jonathan-c-lee/elevate/README.md

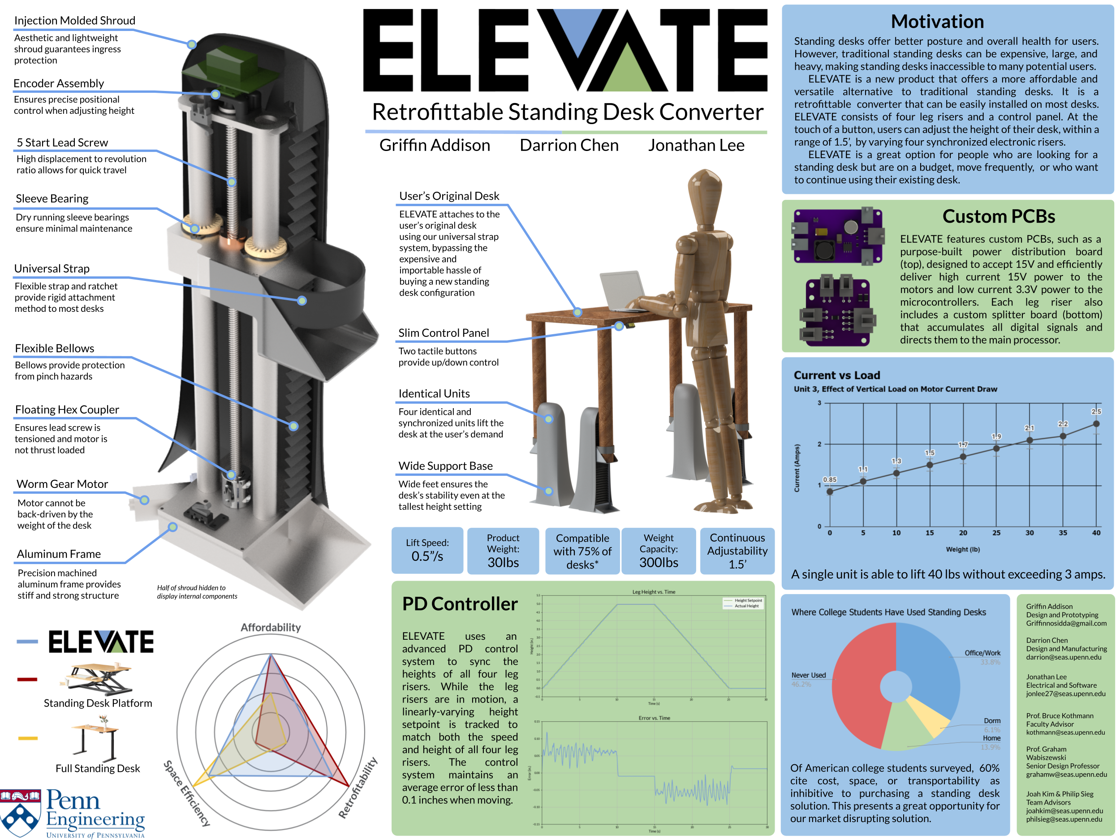
[picture p1: media/poster/ELEVATE Design Poster.png]
ELEVATE


[TESTING VIDEO](https://youtu.be/RrBmovzpD_M)
