jonathan-c-lee/elevate/media/presentations/09_ELEVATE_prototypePresentation.pdf

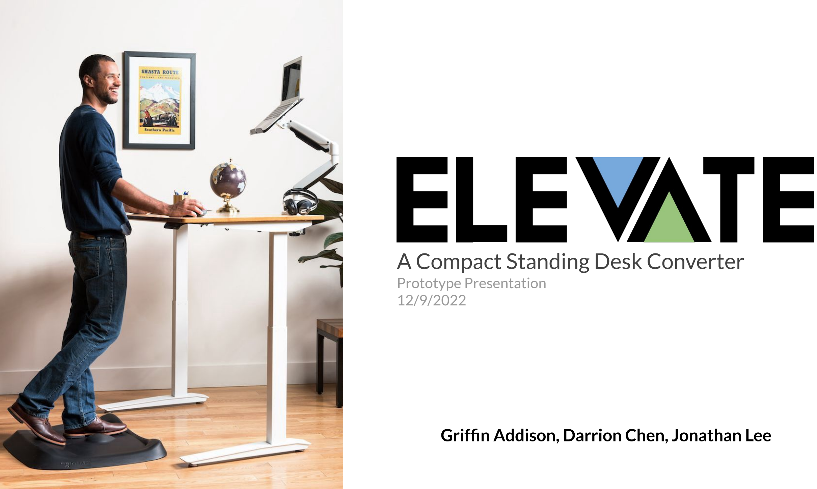
[picture p2: page 1]

A Compact Standing Desk Converter
Prototype Presentation
12/9/2022

Griffin Addison, Darrion Chen, Jonathan Lee

# The Problem

Adjustable standing desks have several physical and mental health benefits. However, there currently exists a barrier to entry for potential standing desk customers. Their only available options are to buy a new standing desk or an obtrusive standing desk converter. The former has a high cost and lacks portability while the latter lacks the full capabilities of a true adjustable standing desk.

Expensive | Lack of Portability | Obtrusive

# The Market

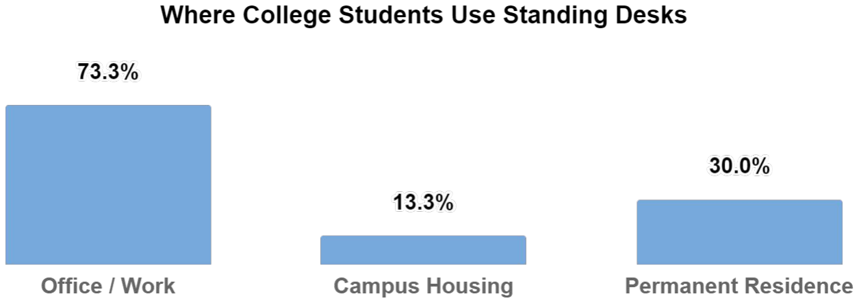
[picture p3: figure]

50%
of college students have used standing desks

86.7%
of college students who have used standing desks do not use a standing desk on campus

45%
of college students have used true standing desks

# The Competition

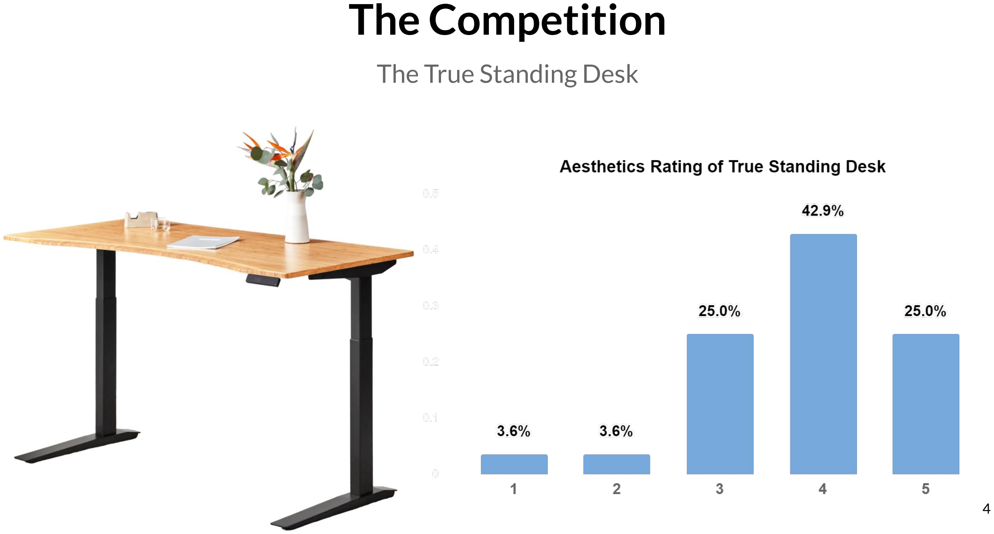
[picture p4: page 4]

The True Standing Desk

# The Competition

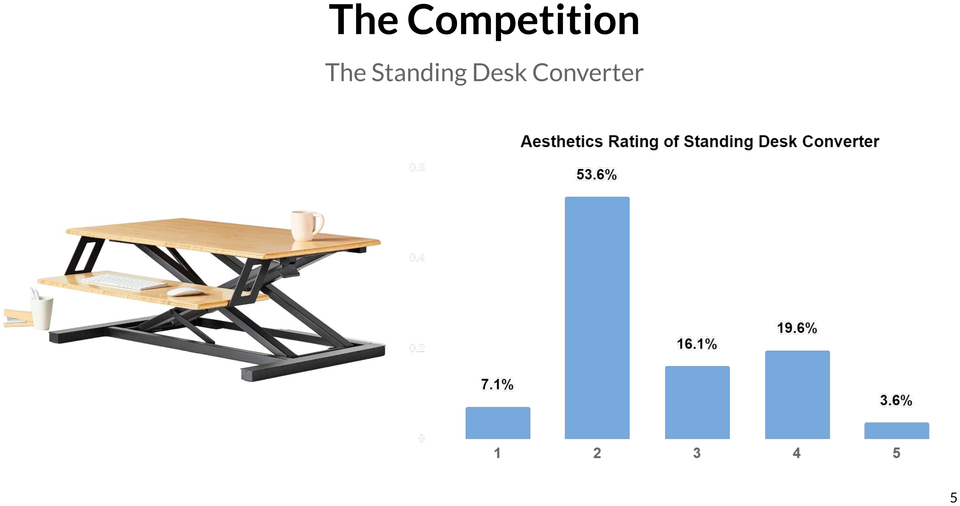
[picture p5: page 5]

The Standing Desk Converter

# The Competition

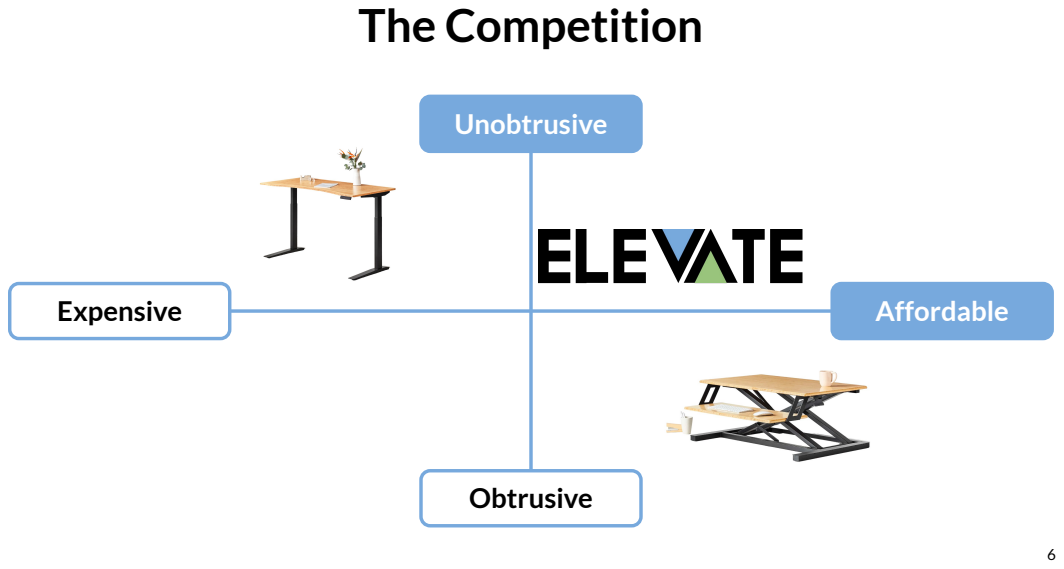
[picture p6: page 6]
Expensive; Affordable; Unobtrusive; Obtrusive

# Our Customers

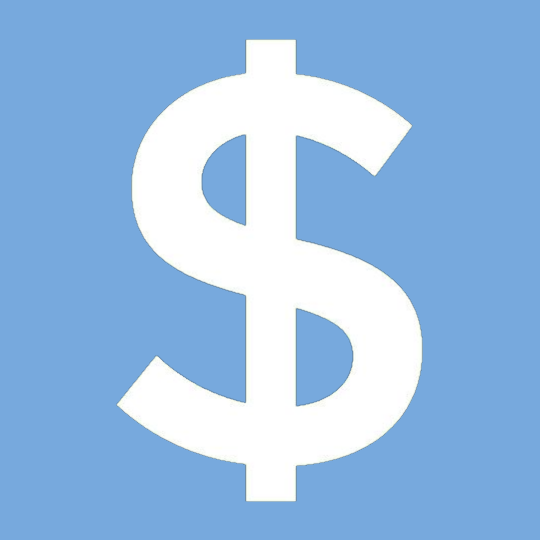
[picture p7: figure]

### Business Owners

and other employees
and employers who
have a budget and are
looking for lower cost
solutions

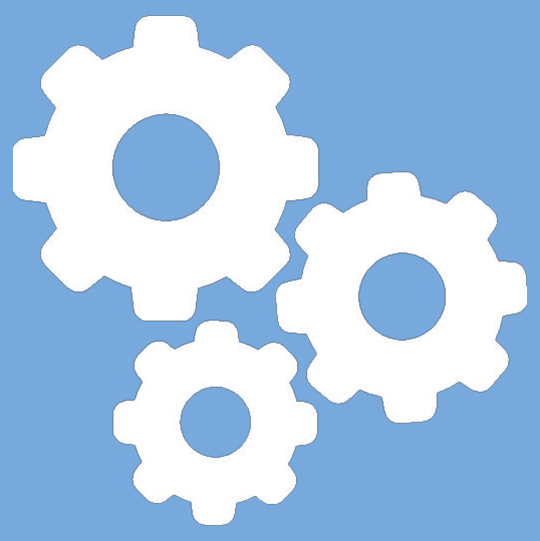
[picture p8: figure]

### Artists

And other individuals
who are looking for a
retrofittable solution
to keep their current
setup

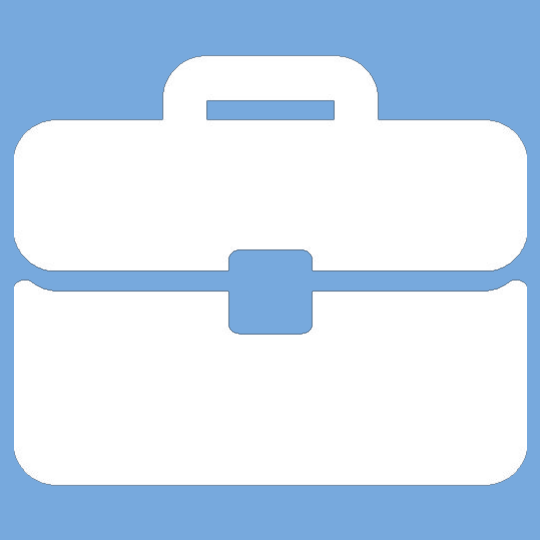
[picture p9: figure]

### College Students

and other individuals
who do not have a
permanent desk setup
and are looking for a
portable solution

# System Characteristics

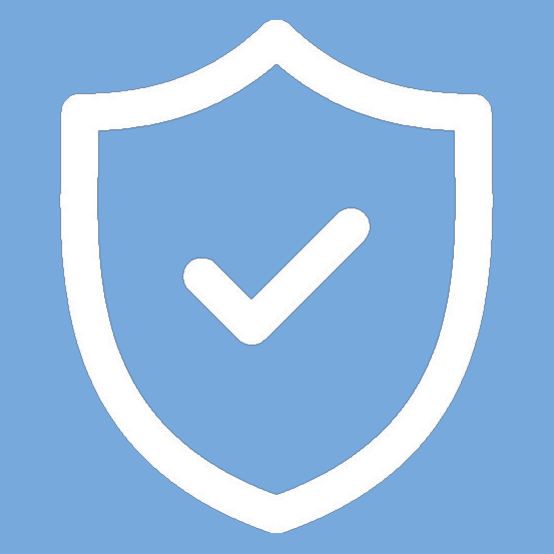
[picture p10: figure]
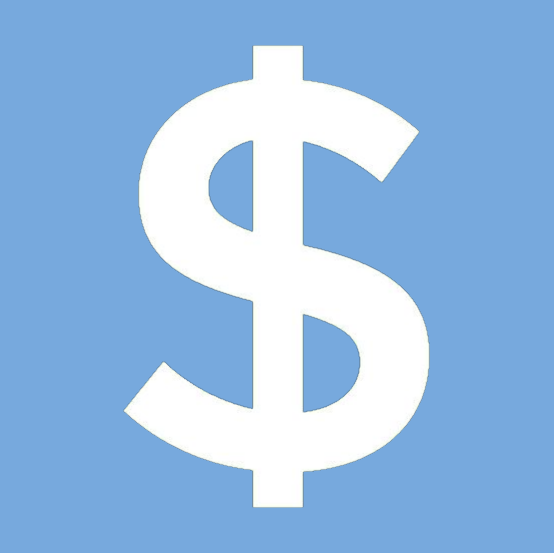
[picture p11: figure]
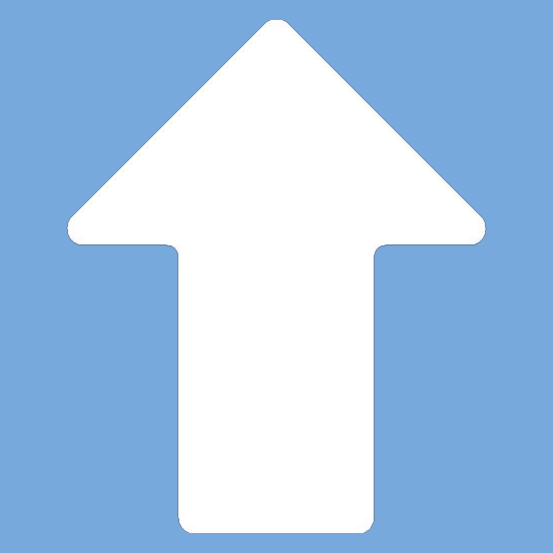
[picture p12: figure]

Functional
300lb at ½” / sec
1.5’ adjustability

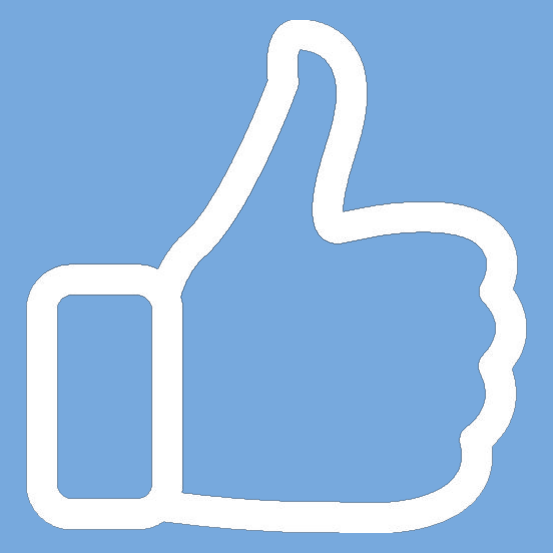
[picture p13: figure]
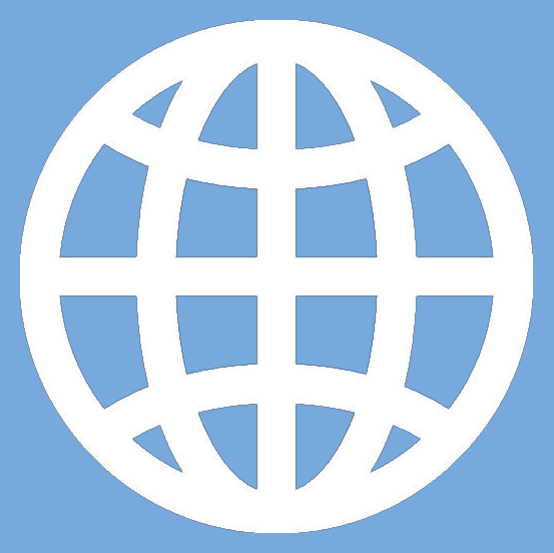
[picture p14: figure]
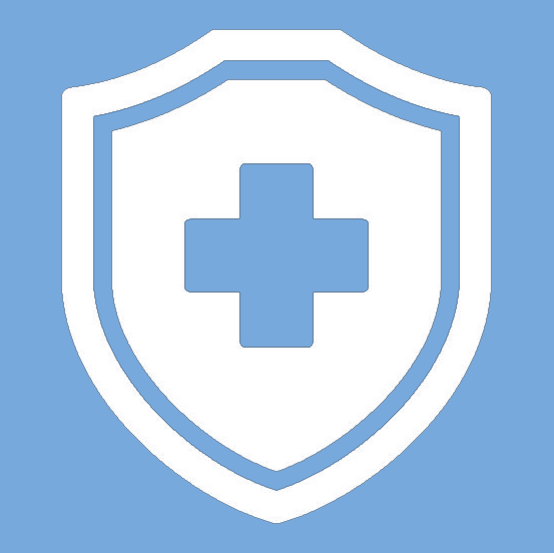
[picture p15: figure]

User-Friendly
Portable
Unobtrusive
Easy to install
Intuitive

Affordable
< $300

Universal
Works for
majority of desks

Reliable
Load cycling
IP62 rating
UL consumer
product ratings

Safe
No backdriving
Rigid
Stable

# Concept Selection

ELEVATE

ELEVATE

ELEVATE

On Desk | Under Legs | Under Desk

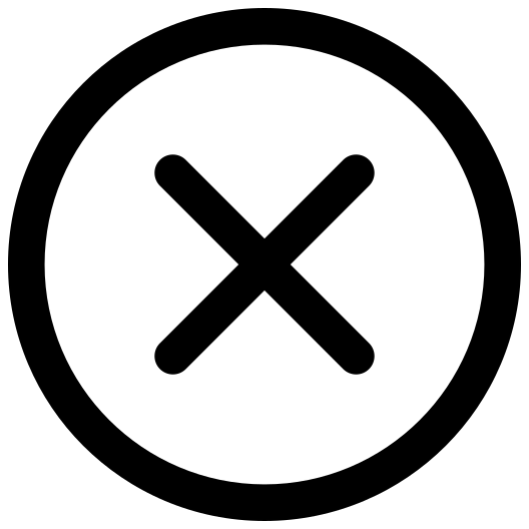
[picture p16: figure]
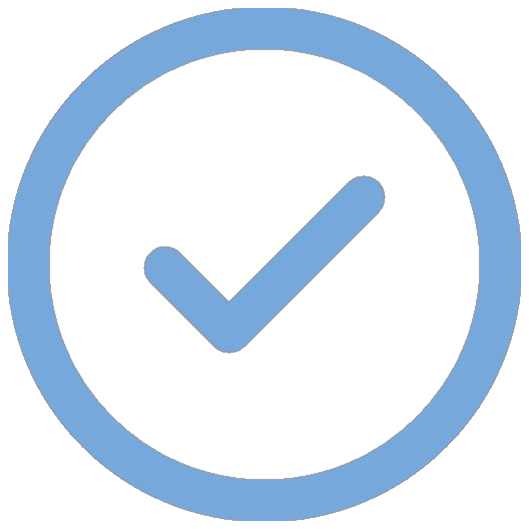
[picture p17: figure]

# System-Level Selection

| Lead Screw | Hydraulics | Pneumatics | Rack and Pinion | Scissor Lift | Cascade Lift
Cost | 5 | 1 | 2 | 4 | 3 | 3
Reliability | 5 | 1 | 3 | 4 | 5 | 1
Complexity | 5 | 1 | 2 | 4 | 3 | 1
Resolution | 3 | 1 | 2 | 4 | 5 | 2
Packaging | 5 | 2 | 3 | 4 | 1 | 1
Safety | 5 | 3 | 3 | 1 | 5 | 1
Total | 28 | 9 | 15 | 21 | 22 | 9

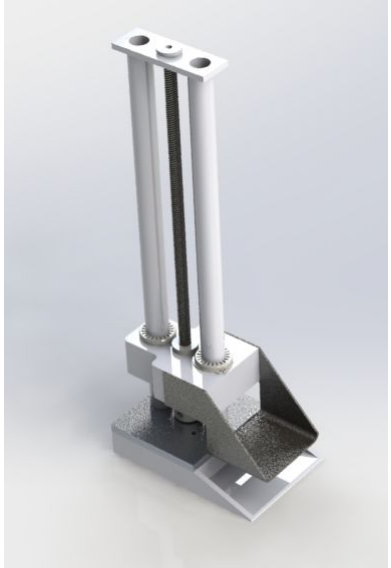
[picture p18: figure]

# Final System Form

### Lead screw with tube supports

### Worm-gear assembly for no backdrive

### Small footprint

### *Covering case hidden to show mechanisms

# Our Advantage

Standing Desk Converter | True Standing Desk

Volume (in³
) | 16” x 5” x 30” | 30” x 25” x 5” | 48” x 30” x 25”
Weight (lb) | 50 | 50 | 110
Cost ($) | 300 | 200 | 500
Retrofittable | Yes | Yes | No
Obtrusive | No | Yes | No
Easy to Install | Yes | Yes | No

# Design, Engineering, Prototyping

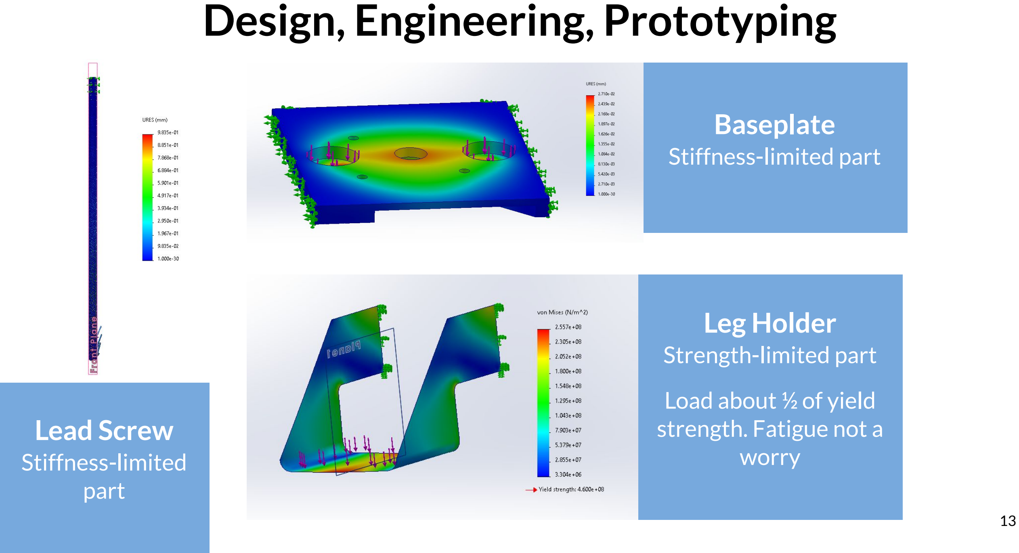
[picture p19: page 13]

Lead Screw
Stiffness-limited
part

Baseplate
Stiffness-limited part

Leg Holder
Strength-limited part

Load about ½ of yield
strength. Fatigue not a
worry

# Design, Engineering, Prototyping

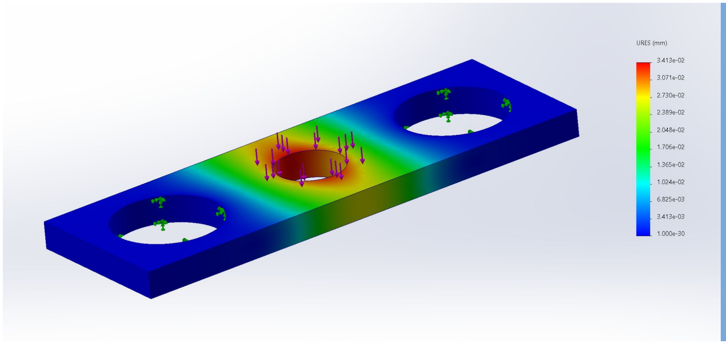
[picture p20: figure]

Top Plate

### Stiffness limited part

### Maximum load, deforms appropriately

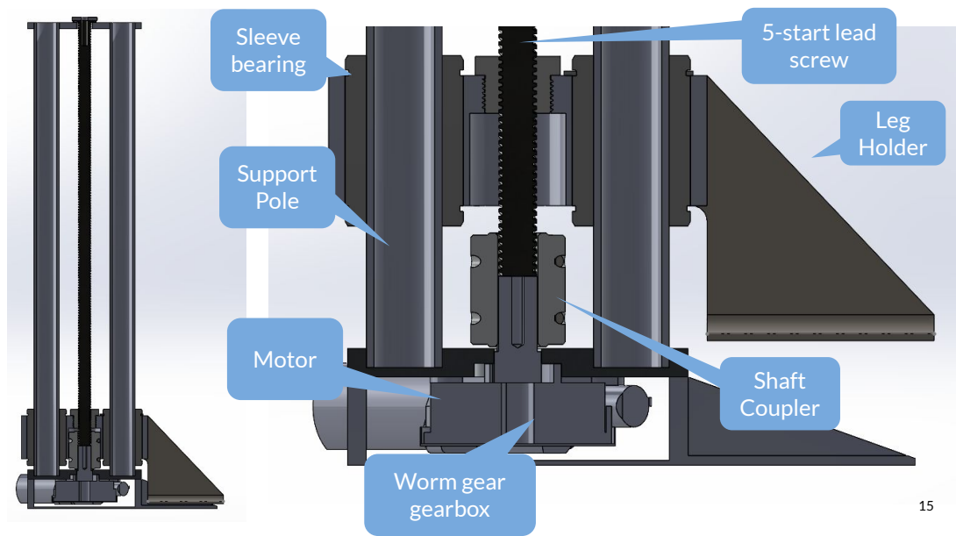
[picture p21: page 15]
Sleeve bearing; Motor; Worm gear gearbox; Shaft Coupler; 5-start lead screw; Leg Holder; Support Pole

# Motor Validation

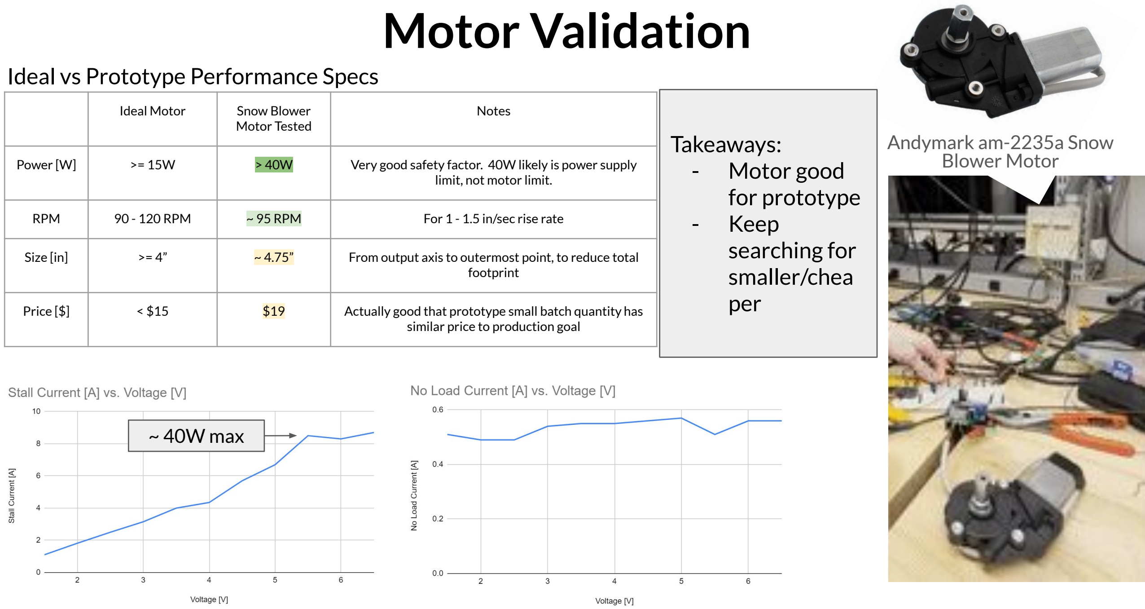
[picture p22: page 16]

Andymark am-2235a Snow
Blower Motor
Ideal Motor | Snow Blower Motor Tested

Notes

Power [W] | >= 15W | > 40W | Very good safety factor. 40W likely is power supply limit, not motor limit.
RPM | 90 - 120 RPM | ~ 95 RPM | For 1 - 1.5 in/sec rise rate
Size [in] | >= 4” | ~ 4.75” | From output axis to outermost point, to reduce total footprint
Price [$] | < $15 | $19 | Actually good that prototype small batch quantity has similar price to production goal

~ 40W max

Ideal vs Prototype Performance Specs

Takeaways:
- Motor good
for prototype
- Keep
searching for
smaller/chea
per

# Our Timeline Fall Deliverables

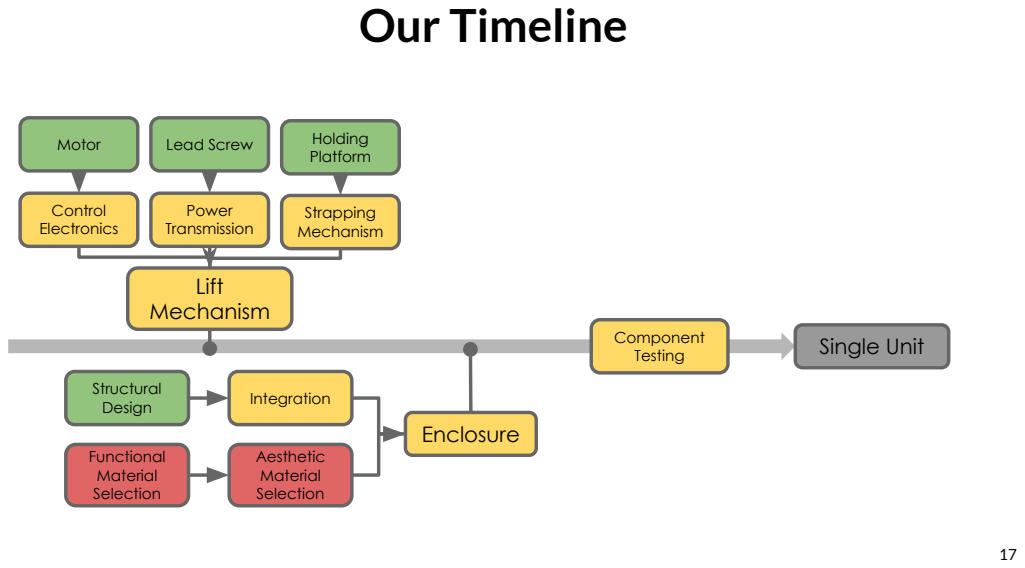
[picture p23: page 17]
Motor; Control Electronics; Lead Screw; Power Transmission; Lift Mechanism; Structural; Design; Integration; Functional Material Selection; Aesthetic Material Selection; Enclosure; Strapping Mechanism; Holding Platform

Single Unit Component
Testing

# Our Timeline Fall Deliverables

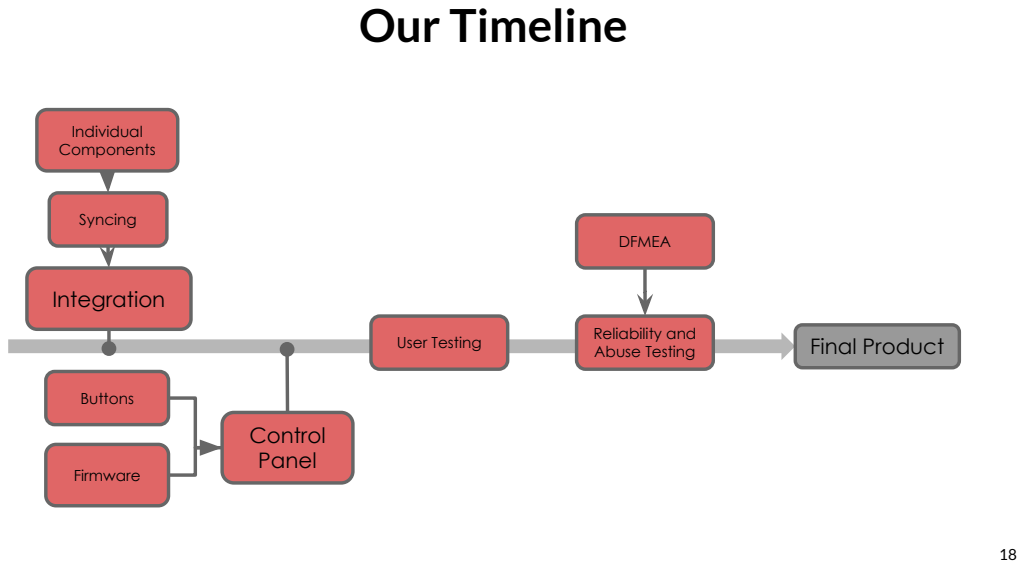
[picture p24: page 18]
Individual Components; Syncing; Integration; Buttons; Firmware; Control Panel; User Testing; DFMEA

Final Product Reliability and
Abuse Testing

# The Team

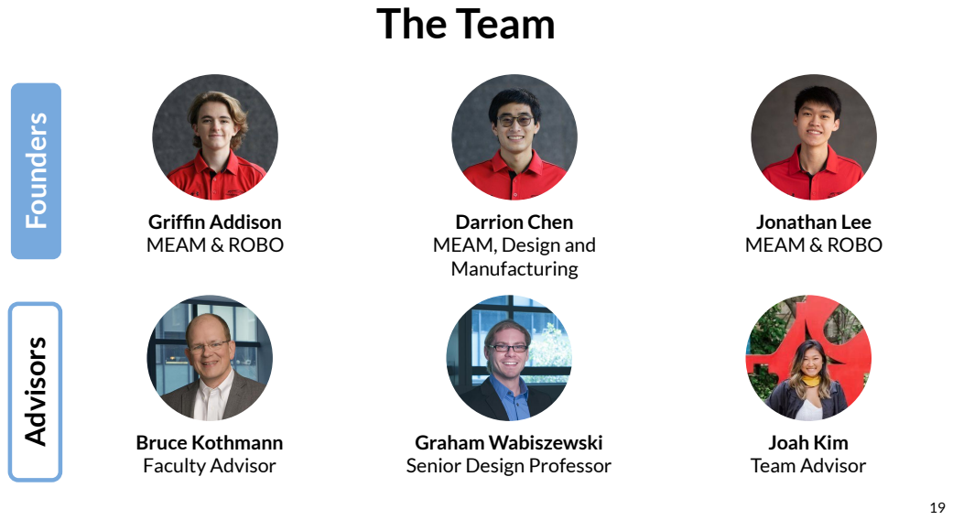
[picture p25: page 19]
Advisors; Bruce Kothmann Faculty Advisor; Joah Kim Team Advisor; Founders; Griffin Addison MEAM & ROBO; Jonathan Lee MEAM & ROBO

Darrion Chen
MEAM, Design and
Manufacturing

Graham Wabiszewski
Senior Design Professor

# References and Photo Credits

- Slide 1
- https://medium.com/halting-problem/local-engineer-refuses-to-work-without-a-standing-desk-fa3c0ef7a2a4
- Slide 4
- https://www.fully.com/jarvis-adjustable-height-desk-bamboo.html
- Slide 5
- https://www.fully.com/cooper-standing-desk-converter.html
- Slide 6
- https://www.fully.com/jarvis-adjustable-height-desk-bamboo.html
- https://www.fully.com/cooper-standing-desk-converter.html
