jonathan-c-lee/elevate/control_plots/riser_balance.png

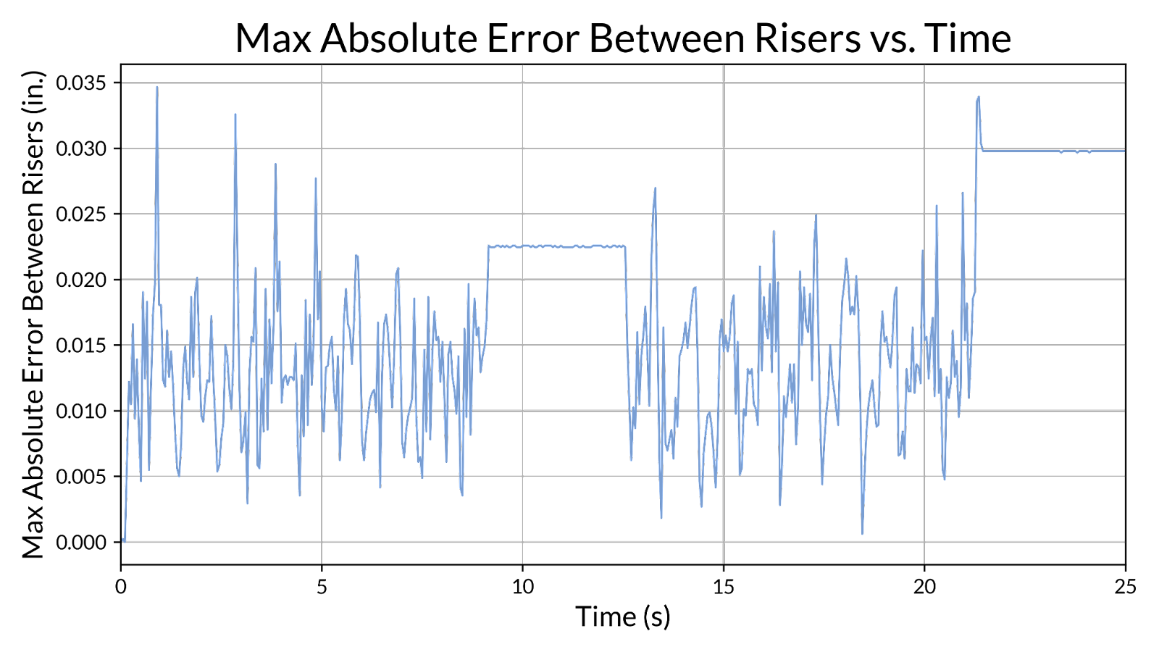
control_plots/riser_balance.png
