jonathan-c-lee/elevate/control_plots/riser_error.png

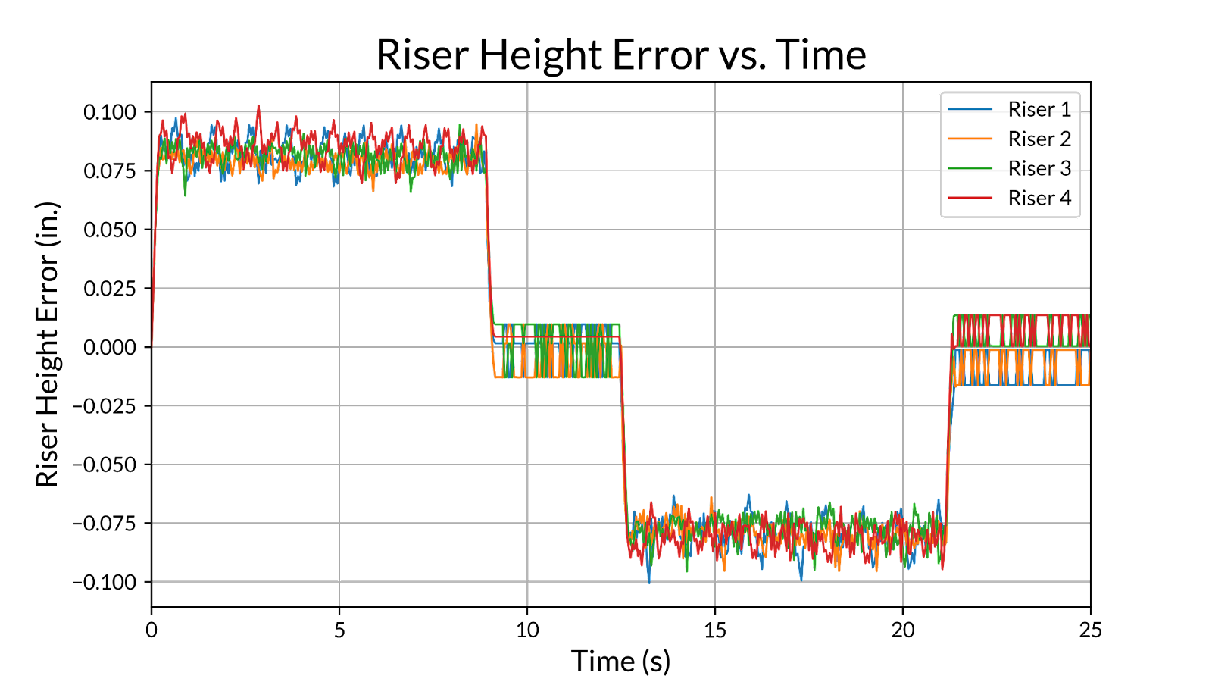
control_plots/riser_error.png
