jonathan-c-lee/elevate/control_plots/trajectory_comparison.png

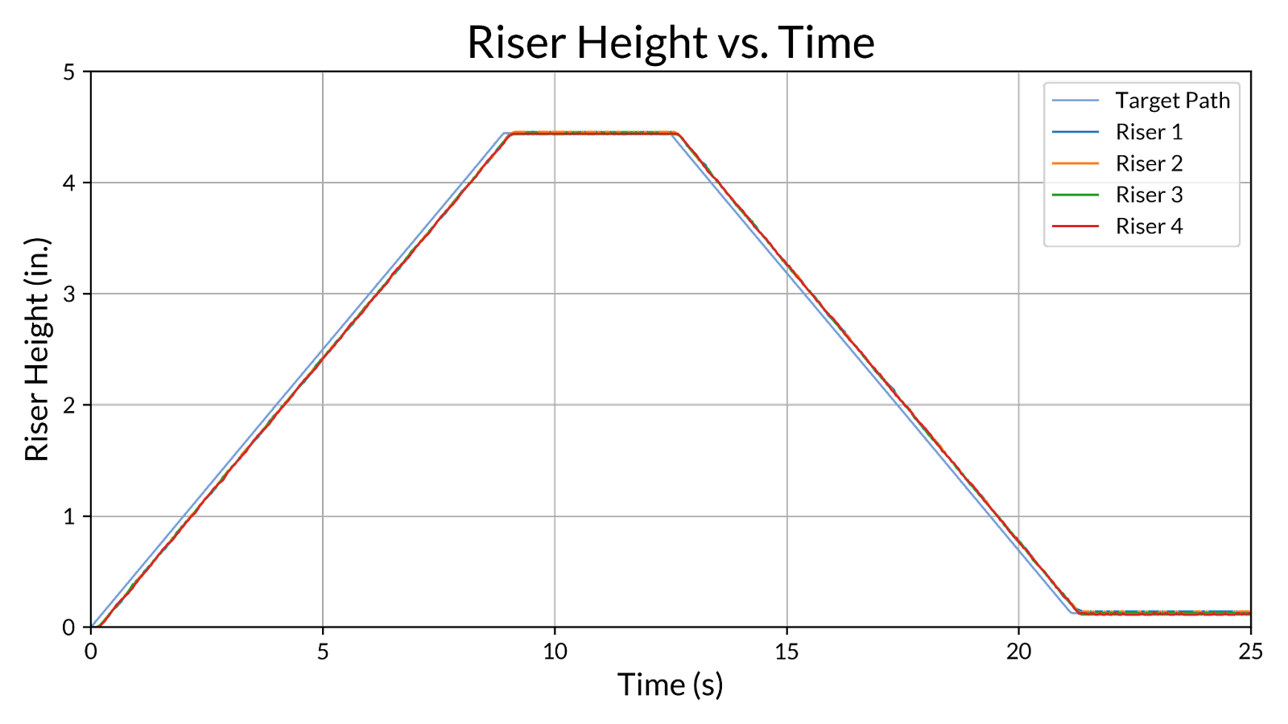
control_plots/trajectory_comparison.png
