jonathan-c-lee/elevate/electrical/circuit_diagrams/button_panel_board.png

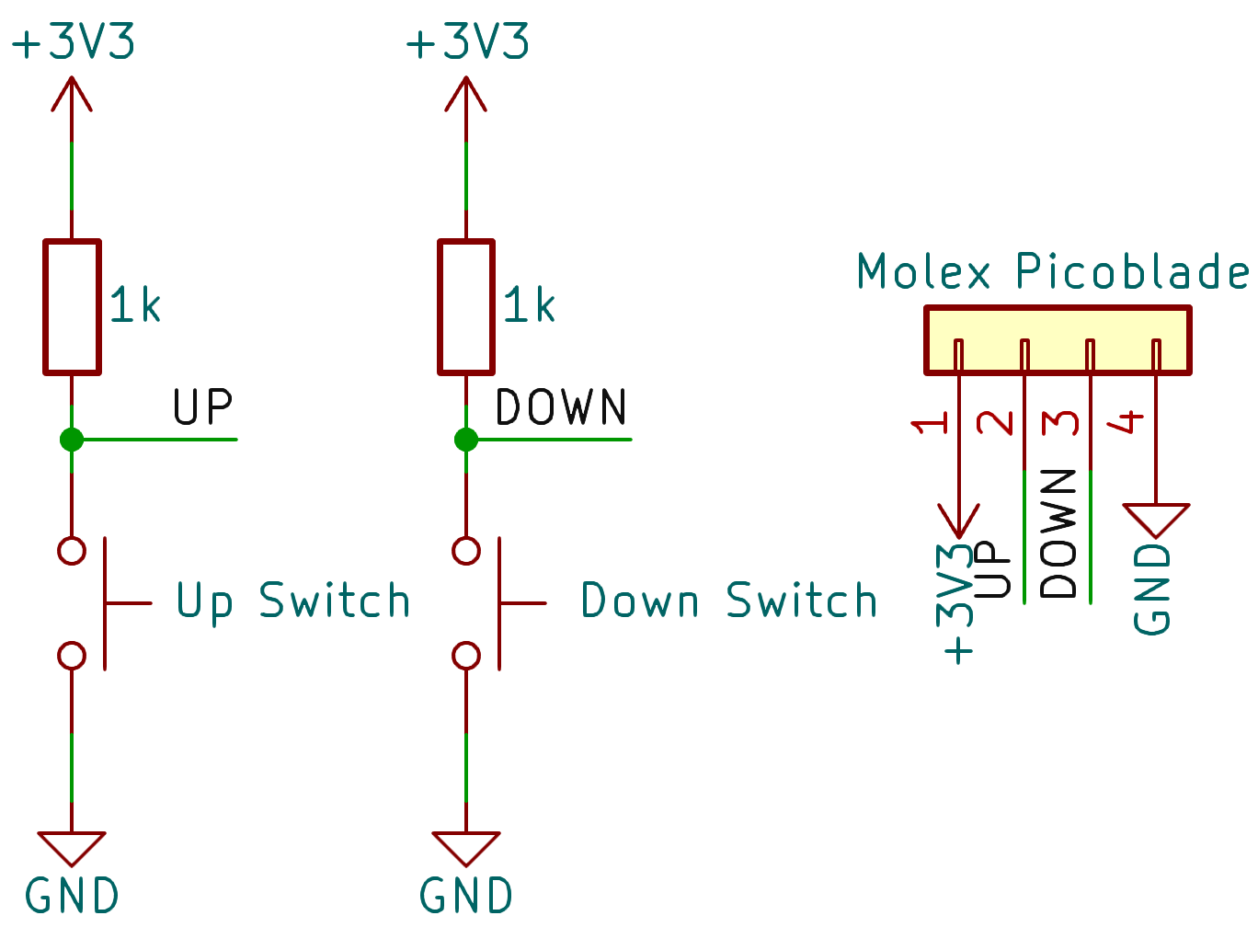
electrical/circuit_diagrams/button_panel_board.png
