jonathan-c-lee/elevate/electrical/circuit_diagrams/module_architecture.png

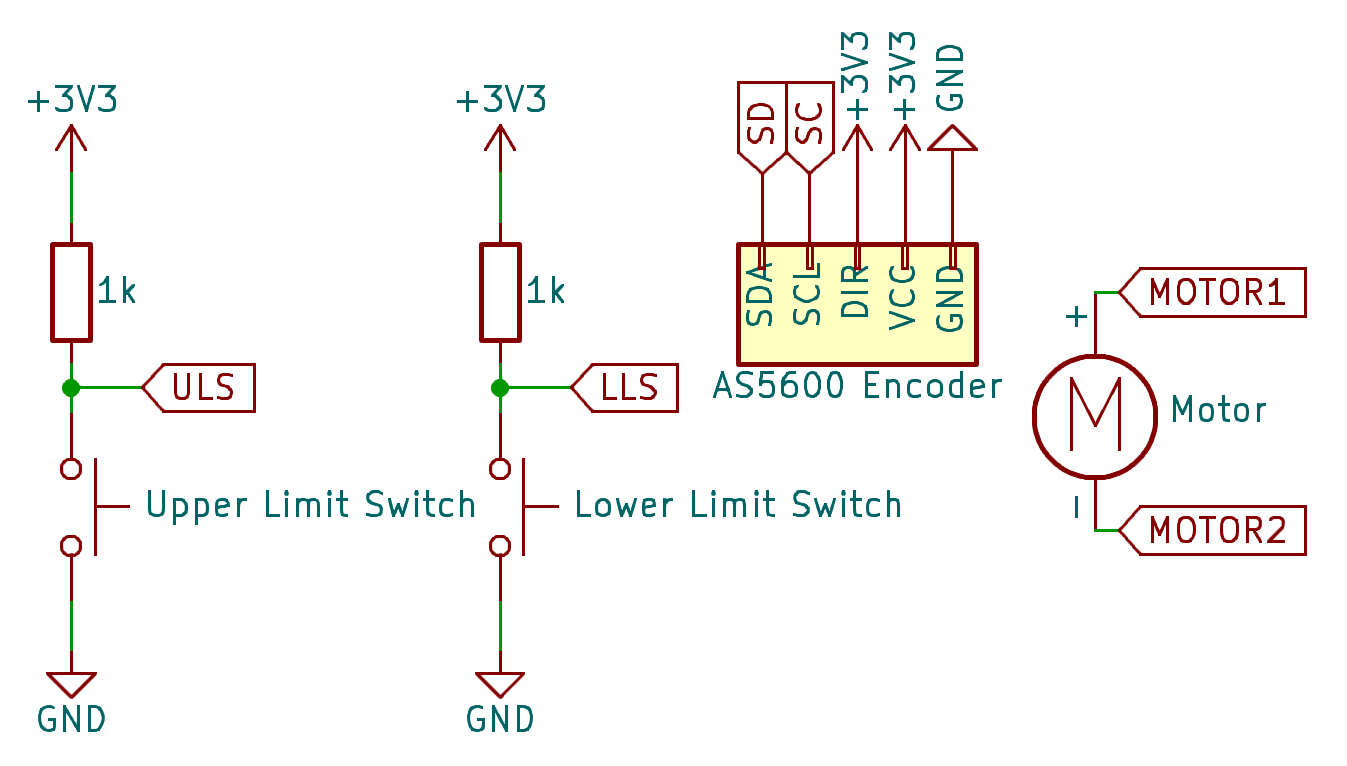
electrical/circuit_diagrams/module_architecture.png
