jonathan-c-lee/elevate/electrical/circuit_diagrams/power_distribution_board.png

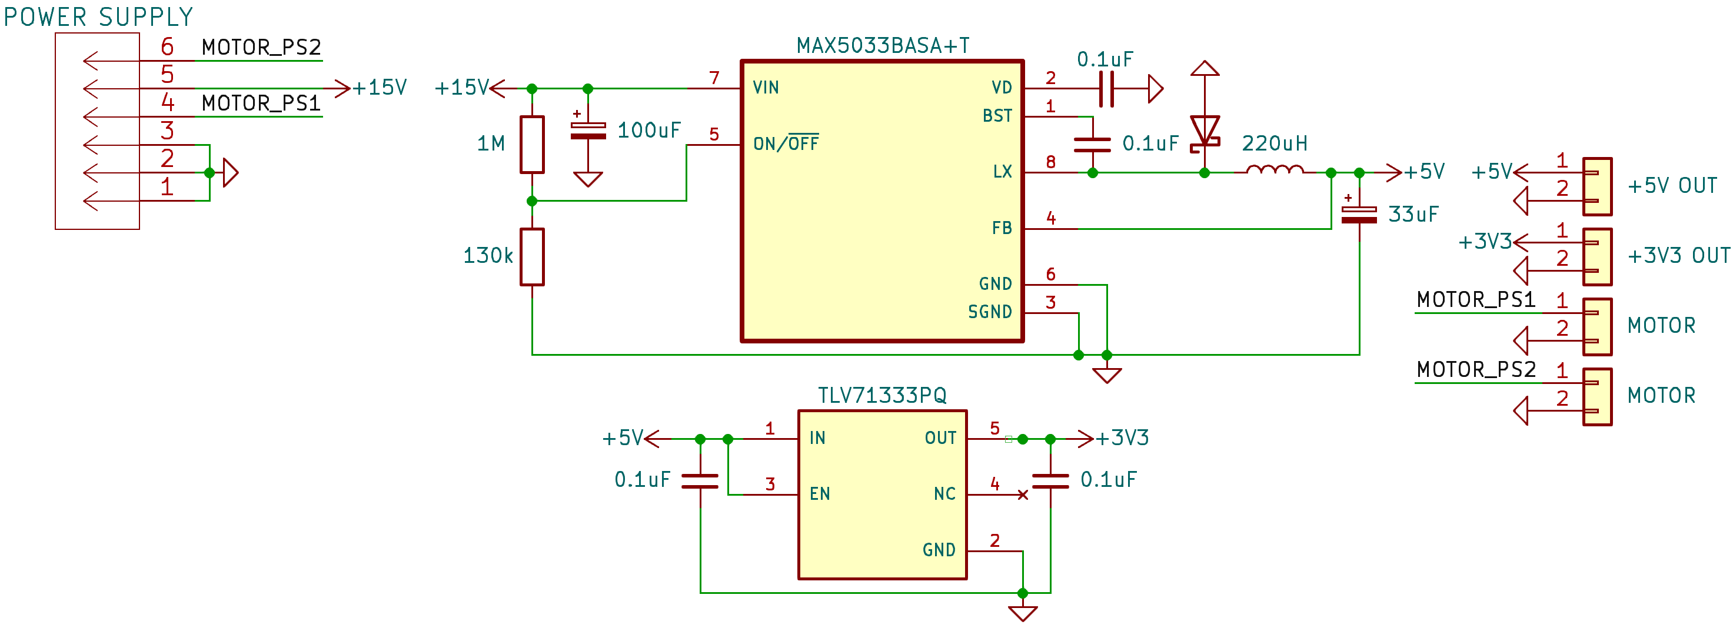
electrical/circuit_diagrams/power_distribution_board.png
