jonathan-c-lee/elevate/electrical/circuit_diagrams/simplified_electrical_architecture.png

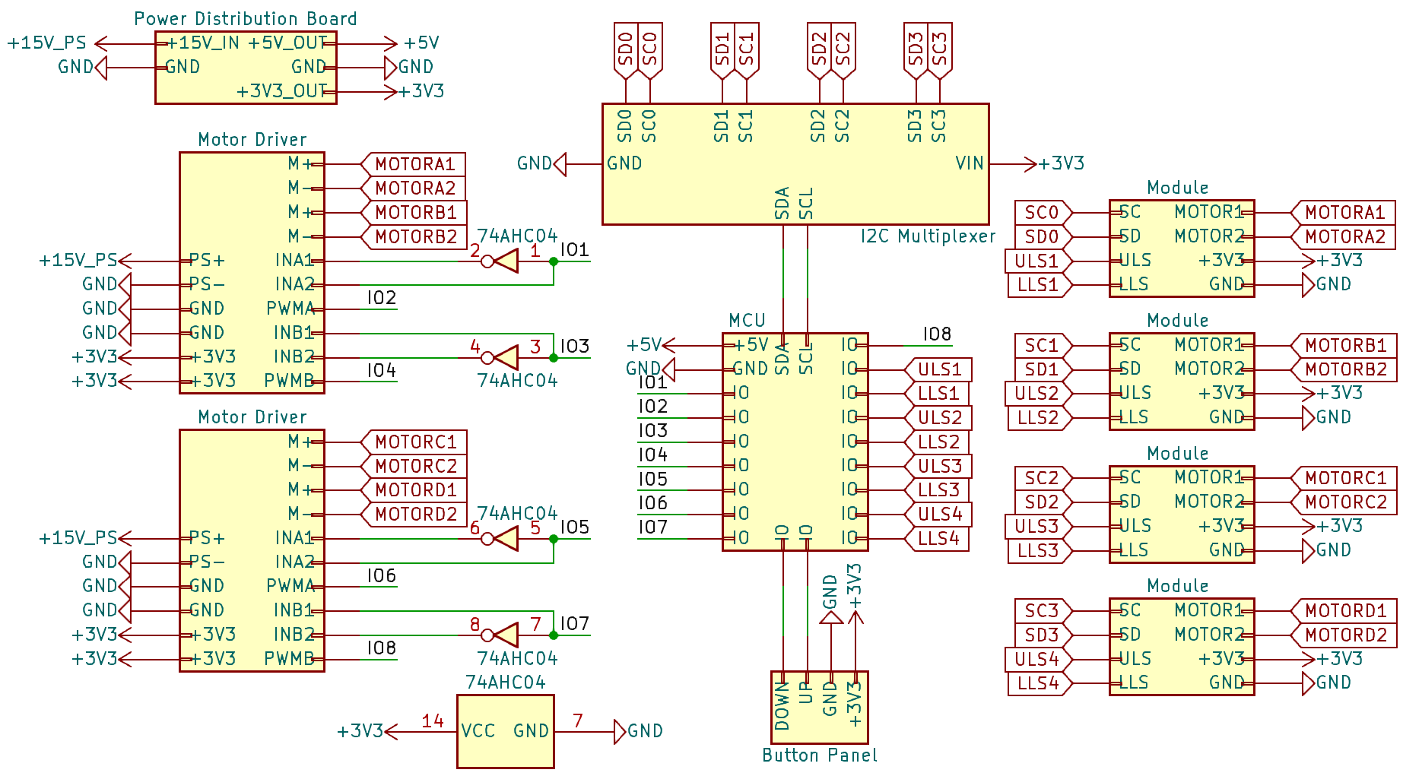
electrical/circuit_diagrams/simplified_electrical_architecture.png
