jonathan-c-lee/elevate/electrical/circuit_diagrams/splitter_board.png

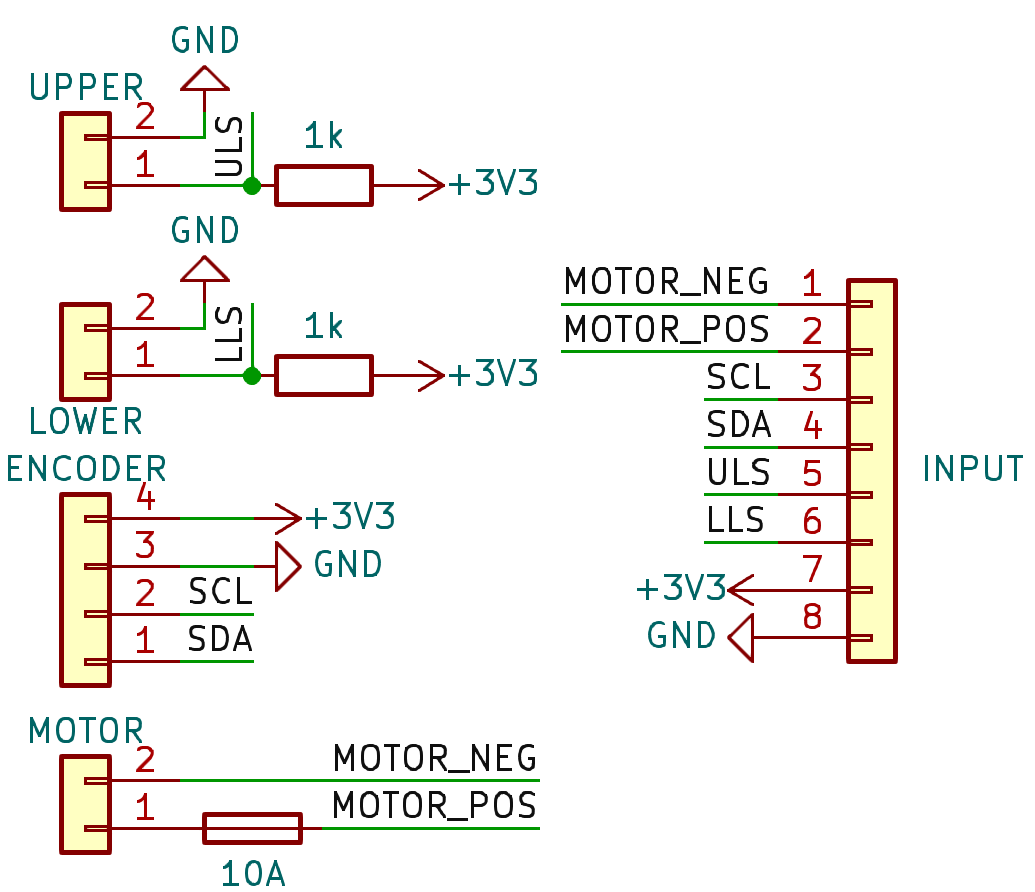
electrical/circuit_diagrams/splitter_board.png
