jonathan-c-lee/elevate/media/diagrams/control_scheme.png

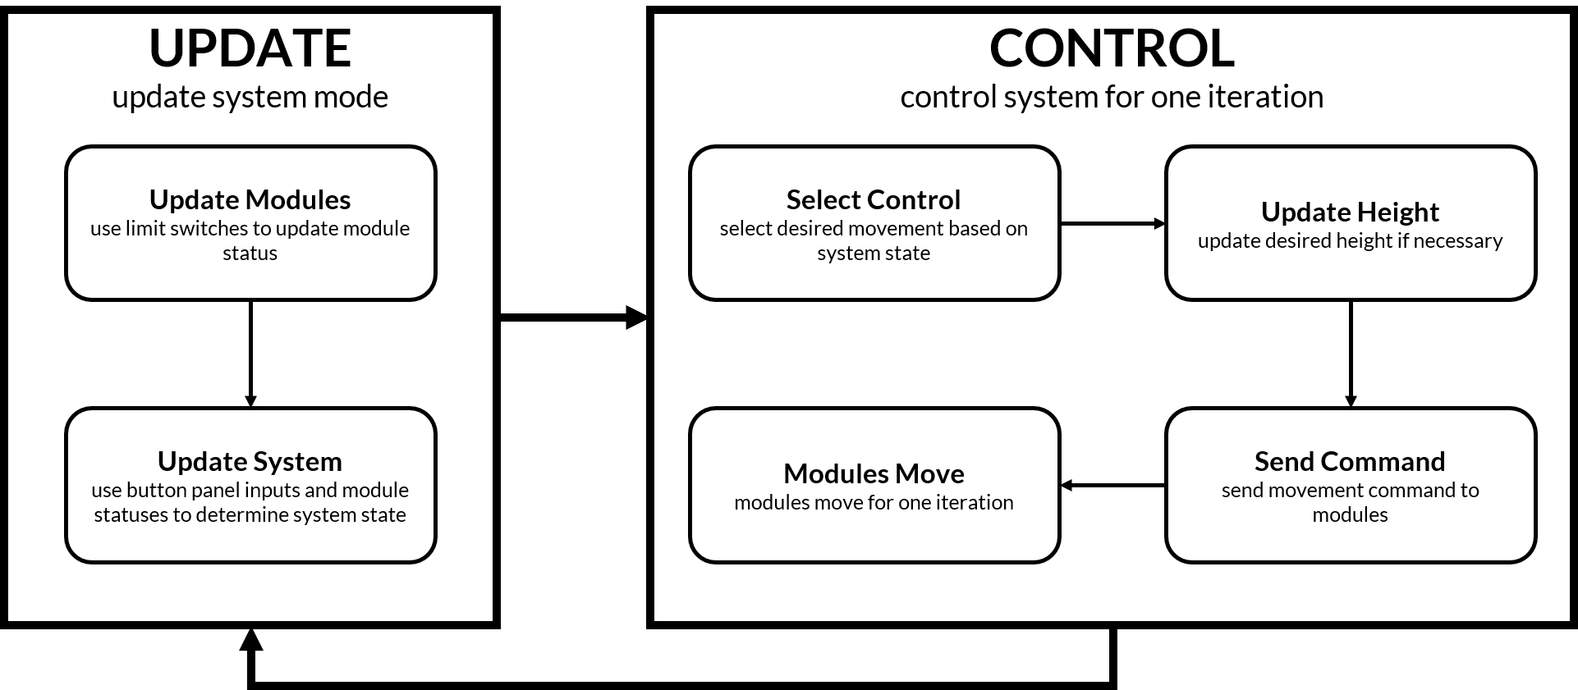
media/diagrams/control_scheme.png
