jonathan-c-lee/elevate/media/diagrams/normal_pid.png

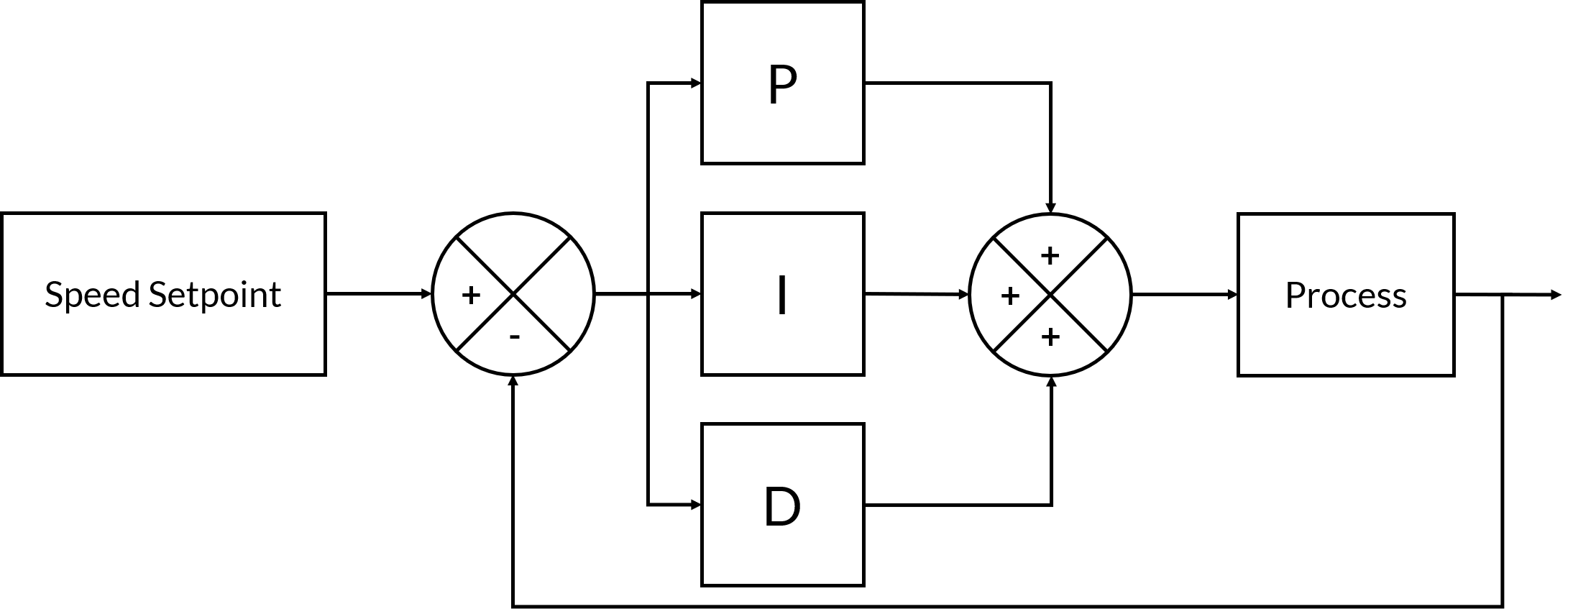
media/diagrams/normal_pid.png
