jonathan-c-lee/elevate/media/diagrams/varying_setpoint_pd.png

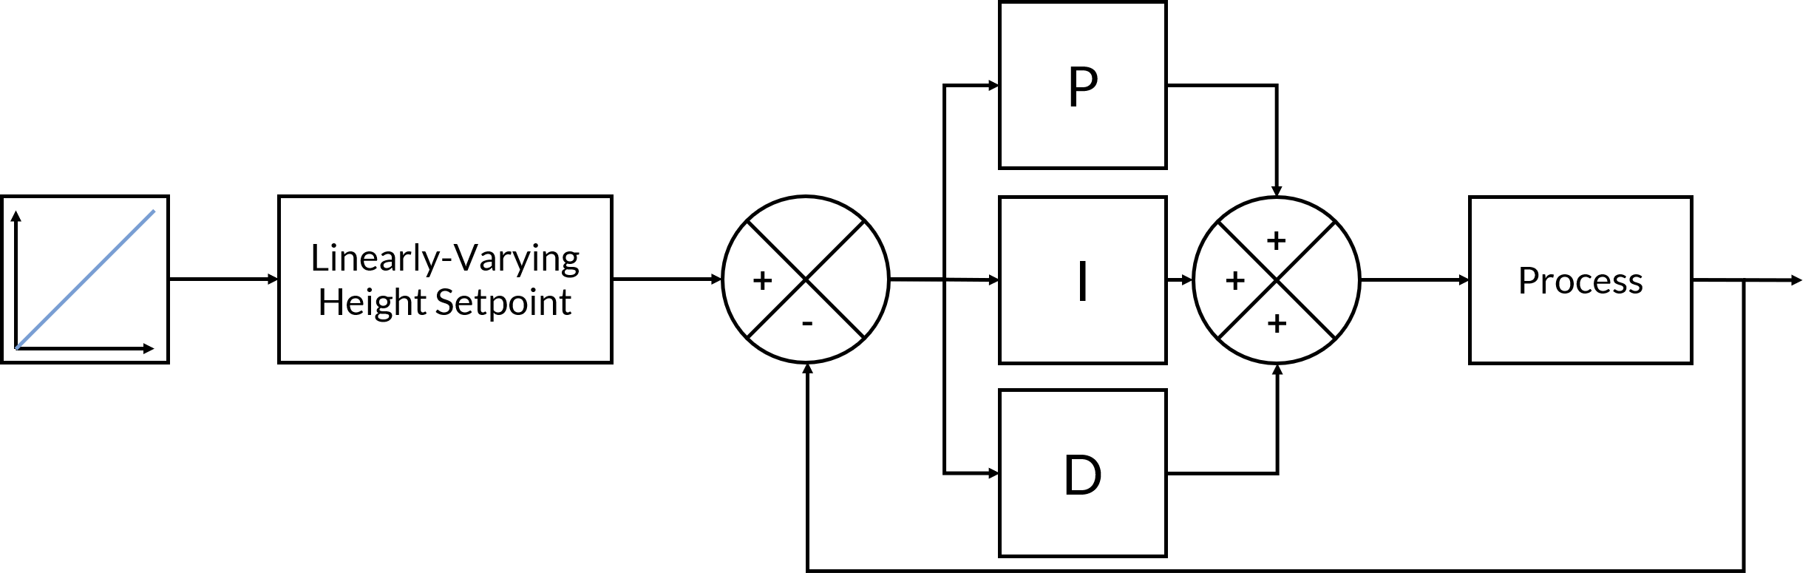
media/diagrams/varying_setpoint_pd.png
