jonathan-c-lee/elevate/media/img/riser_breakdown.png

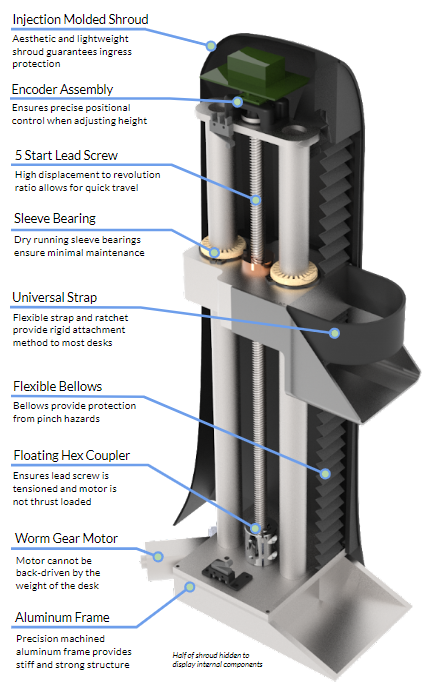
media/img/riser_breakdown.png
