jonathan-c-lee/elevate/media/img/riser_prototype.png

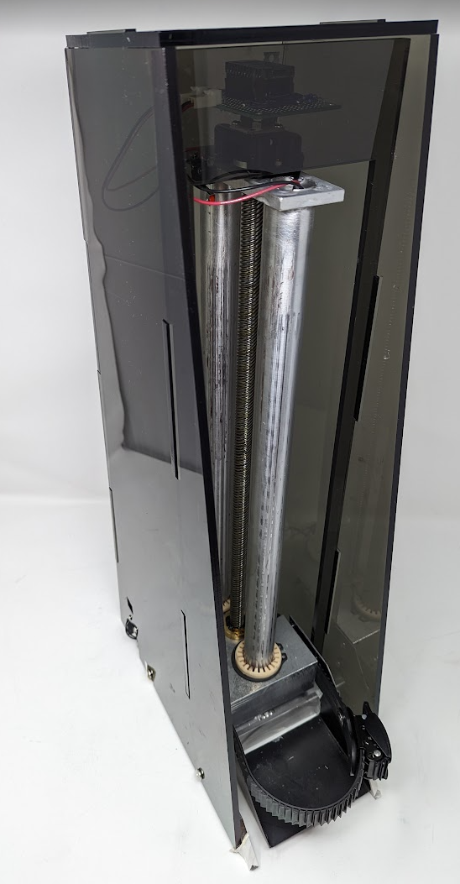
media/img/riser_prototype.png
