jonathan-c-lee/elevate/electrical/kicad_files/button_panel/Desk Panel.step

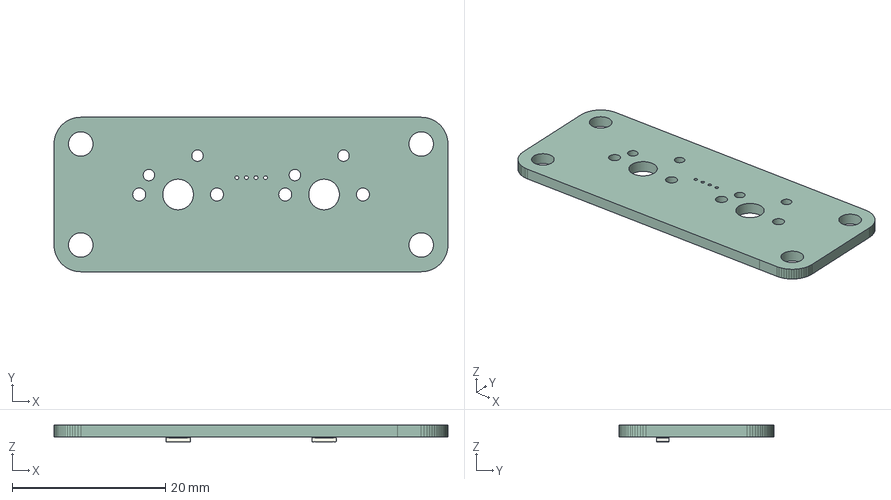
[picture p39: CAD file, 2023-05-07]
electrical/kicad_files/button_panel/Desk Panel.step
51.5 x 20.2 x 2.18 mm
PCB
