jonathan-c-lee/elevate/electrical/kicad_files/power_distribution_board/Power Distribution Board.step

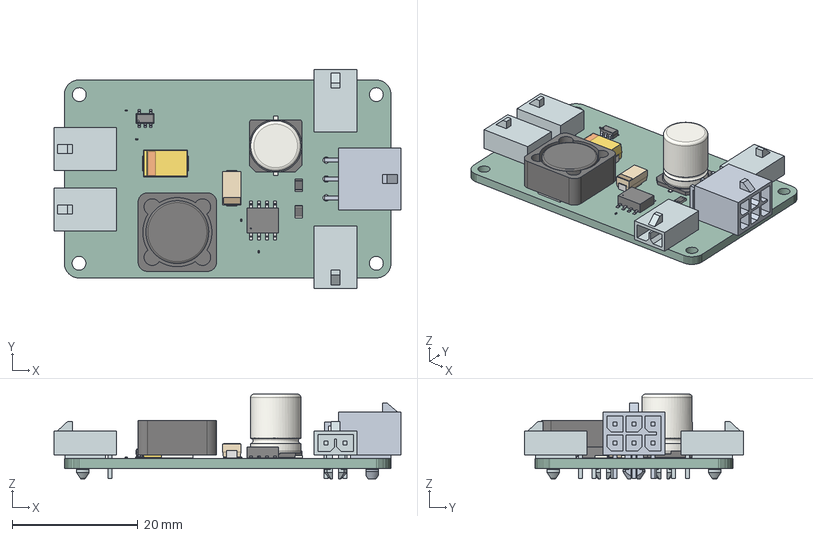
[picture p40: CAD file, 2023-05-07]
electrical/kicad_files/power_distribution_board/Power Distribution Board.step
55.2 x 34.9 x 13.5 mm
PCB
