jonathan-c-lee/elevate/electrical/kicad_files/power_distribution_board/parts/SMA_DIO.step

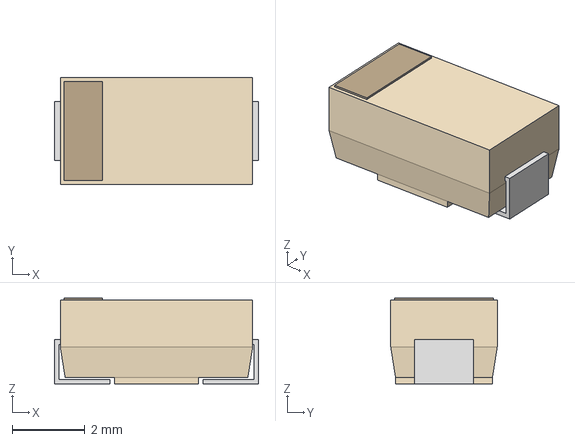
[picture p41: CAD file, 2023-05-07]
electrical/kicad_files/power_distribution_board/parts/SMA_DIO.step
5.59 x 2.92 x 2.35 mm
