jonathan-c-lee/elevate/electrical/kicad_files/spliiter_board/Module Board.step

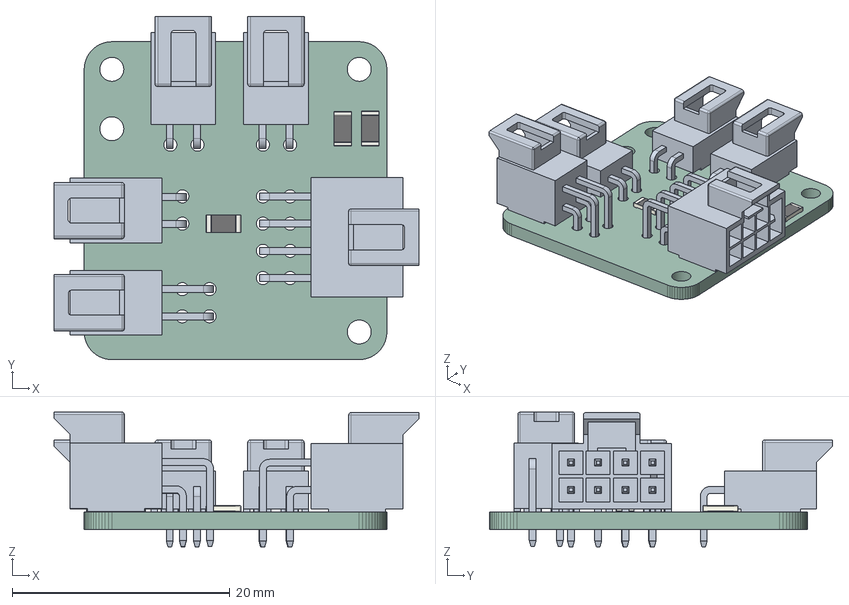
[picture p42: CAD file, 2023-05-07]
electrical/kicad_files/spliiter_board/Module Board.step
33.5 x 31.5 x 12.4 mm
PCB
