jonathan-c-lee/elevate/electrical/kicad_files/power_distribution_board/parts/21-0041B_8_MXM.step

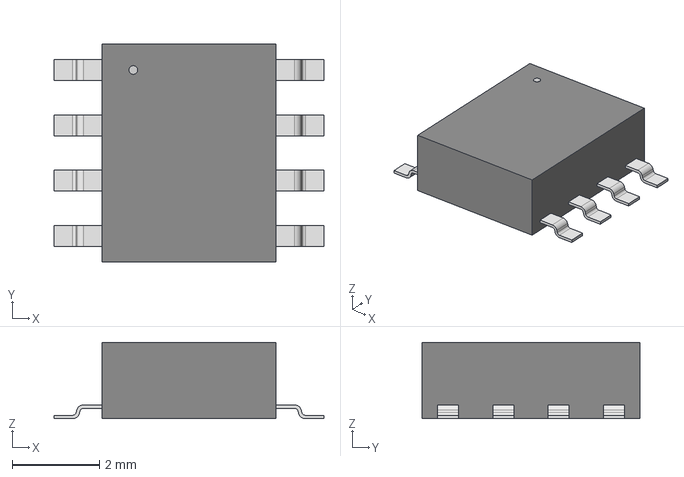
[picture p43: CAD file, 2023-05-07]
electrical/kicad_files/power_distribution_board/parts/21-0041B_8_MXM.step
6.20 x 5.00 x 1.75 mm
