jonathan-c-lee/elevate/electrical/kicad_files/power_distribution_board/parts/TLV71333PDBVR.step

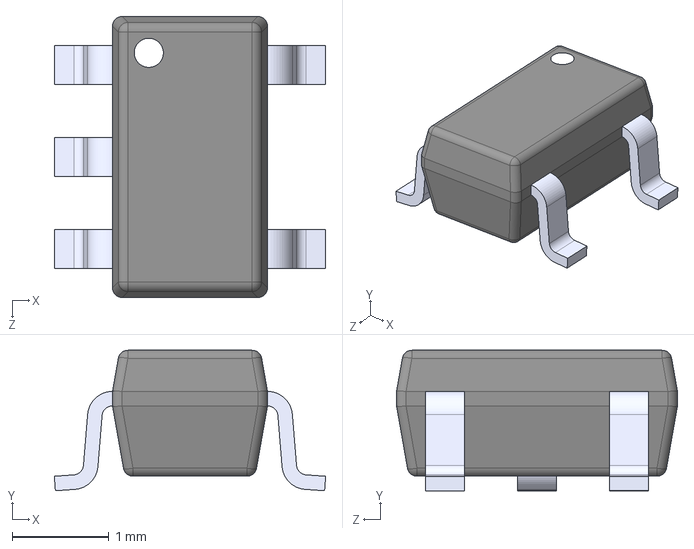
[picture p44: CAD file, 2023-05-07]
electrical/kicad_files/power_distribution_board/parts/TLV71333PDBVR.step
2.80 x 1.45 x 2.90 mm
