jonathan-c-lee/elevate/electrical/kicad_files/spliiter_board/1053131302.stp

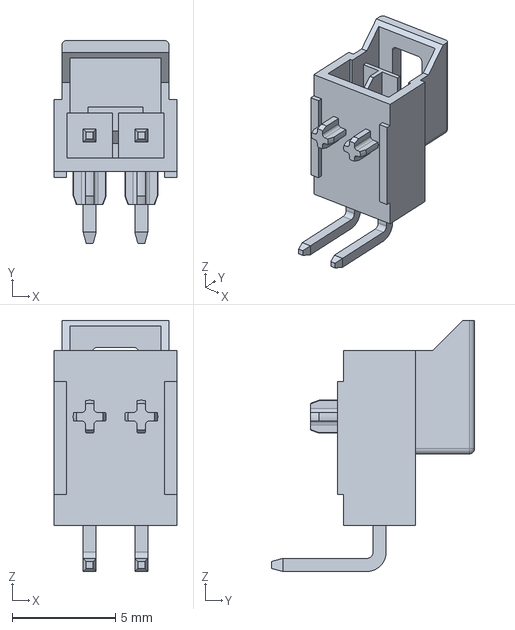
[picture p45: CAD file, 2023-05-07]
electrical/kicad_files/spliiter_board/1053131302.stp
5.94 x 9.84 x 12.2 mm
