jonathan-c-lee/elevate/electrical/kicad_files/spliiter_board/1053141304.stp

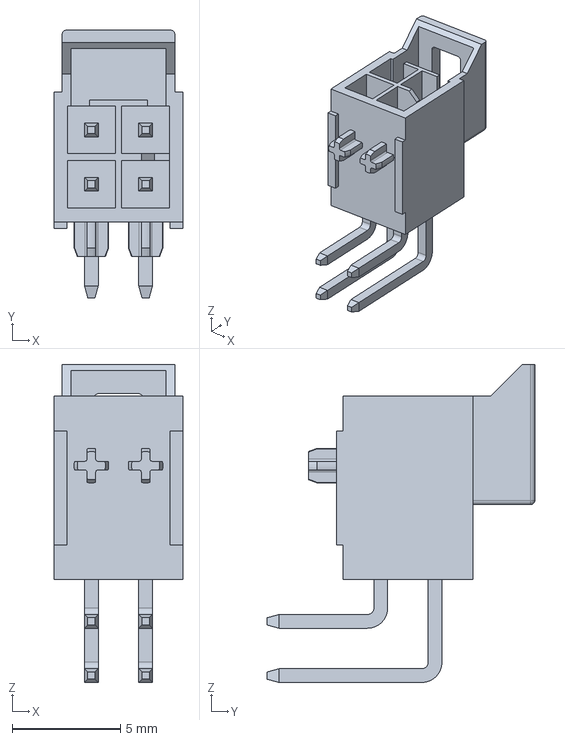
[picture p46: CAD file, 2023-05-07]
electrical/kicad_files/spliiter_board/1053141304.stp
5.94 x 12.3 x 14.7 mm
