jonathan-c-lee/elevate/electrical/kicad_files/power_distribution_board/parts/2157601002.stp

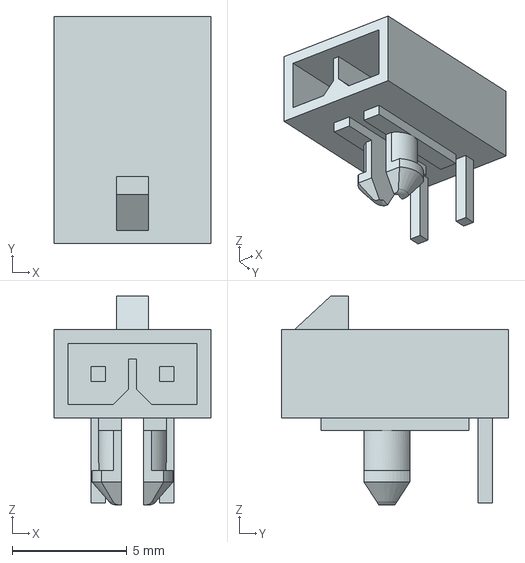
[picture p47: CAD file, 2023-05-07]
electrical/kicad_files/power_distribution_board/parts/2157601002.stp
6.85 x 9.91 x 9.12 mm
