jonathan-c-lee/elevate/electrical/kicad_files/spliiter_board/1053141308.stp

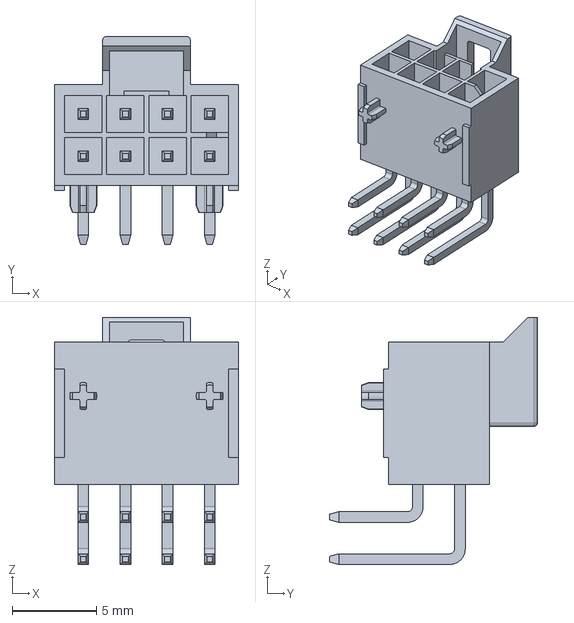
[picture p48: CAD file, 2023-05-07]
electrical/kicad_files/spliiter_board/1053141308.stp
10.9 x 12.3 x 14.7 mm
