jonathan-c-lee/elevate/electrical/kicad_files/power_distribution_board/parts/2125280601.stp

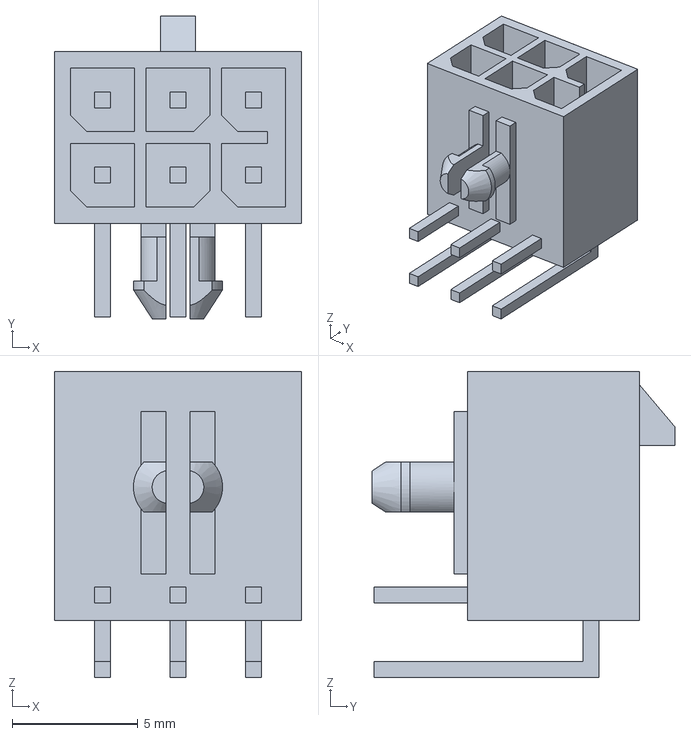
[picture p49: CAD file, 2023-05-07]
electrical/kicad_files/power_distribution_board/parts/2125280601.stp
9.85 x 12.1 x 12.2 mm
