jonathan-c-lee/elevate/media/poster/ELEVATE Design Poster.pdf

# Retrofittable Standing Desk Converter

# Motivation

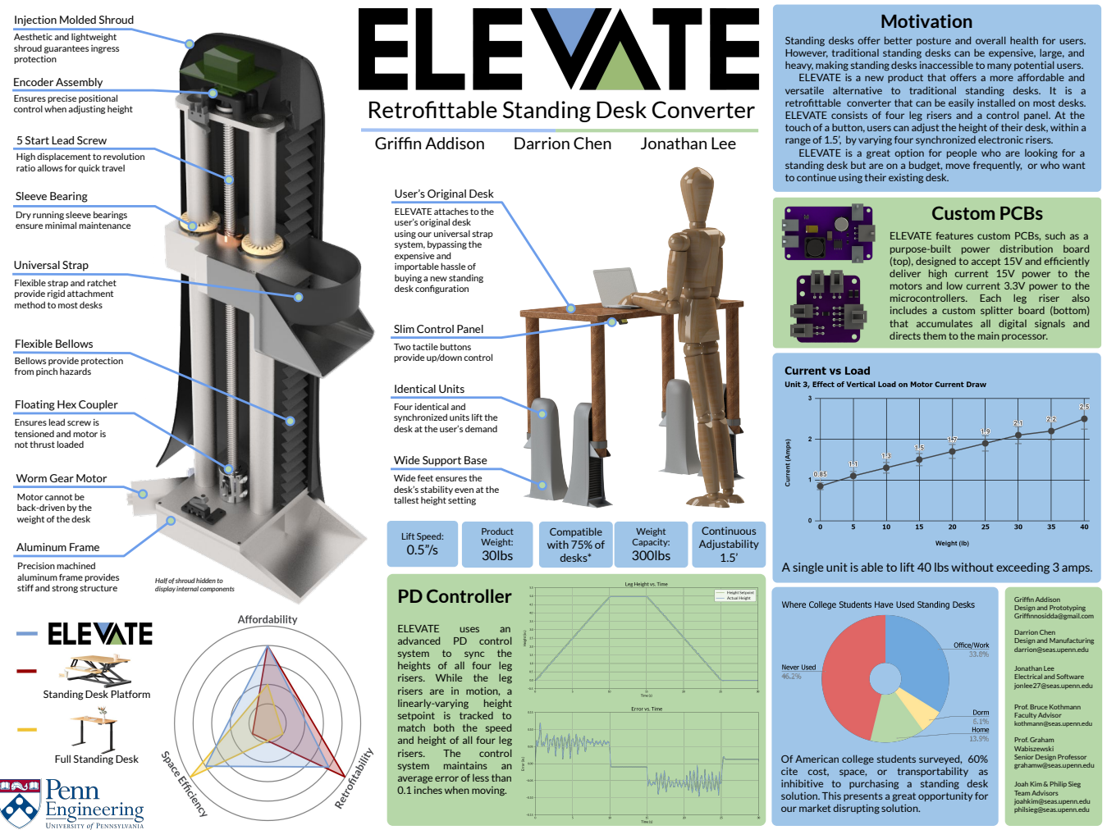
[picture p50: page 1]
Weight Capacity: 300lbs; Lift Speed: 0.5”/s; Product Weight: 30lbs; Compatible with 75% of desks*; ELEVATE; uses; system; sync; the; linearly-varying; height; risers.; The; control; maintains; Griffin Addison; Darrion Chen; Jonathan Lee; Continuous Adjustability 1.5’; Flexible Bellows; Universal Strap; Aluminum Frame; Custom PCBs; PD Controller

Injection Molded Shroud

Aesthetic and lightweight shroud guarantees ingress protection

Standing desks offer better posture and overall health for users.
However, traditional standing desks can be expensive, large, and
heavy, making standing desks inaccessible to many potential users.
ELEVATE is a new product that offers a more affordable and
versatile alternative to traditional standing desks. It is a
retrofittable converter that can be easily installed on most desks.
ELEVATE consists of four leg risers and a control panel. At the
touch of a button, users can adjust the height of their desk, within a
range of 1.5’, by varying four synchronized electronic risers.
ELEVATE is a great option for people who are looking for a
standing desk but are on a budget, move frequently, or who want
to continue using their existing desk.

Encoder Assembly
Ensures precise positional
control when adjusting height

5 Start Lead Screw
High displacement to revolution
ratio allows for quick travel

User’s Original Desk

Sleeve Bearing

ELEVATE attaches to the user’s original desk using our universal strap system, bypassing the expensive and importable hassle of buying a new standing desk configuration

Dry running sleeve bearings ensure minimal maintenance

ELEVATE features custom PCBs, such as a
purpose-built power distribution board
(top), designed to accept 15V and efficiently
deliver high current 15V power to the
motors and low current 3.3V power to the
microcontrollers. Each leg riser also
includes a custom splitter board (bottom)
that accumulates all digital signals and
directs them to the main processor.

Flexible strap and ratchet
provide rigid attachment
method to most desks

Slim Control Panel

Two tactile buttons provide up/down control

Bellows provide protection from pinch hazards

Identical Units

Floating Hex Coupler

Four identical and synchronized units lift the desk at the user’s demand

Ensures lead screw is tensioned and motor is not thrust loaded

Wide Support Base

Worm Gear Motor

Wide feet ensures the desk’s stability even at the tallest height setting

Motor cannot be back-driven by the weight of the desk

Precision machined
aluminum frame provides
stiff and strong structure

A single unit is able to lift 40 lbs without exceeding 3 amps.

Half of shroud hidden to
display internal components

Griffin Addison
Design and Prototyping
Griffinnosidda@gmail.com

advanced PD control
heights of all four leg
risers. While the leg
risers are in motion, a
setpoint is tracked to
match both the speed
and height of all four leg
average error of less than
0.1 inches when moving.

Darrion Chen
Design and Manufacturing
darrion@seas.upenn.edu

Jonathan Lee
Electrical and Software
jonlee27@seas.upenn.edu

Standing Desk Platform

Prof. Bruce Kothmann
Faculty Advisor
kothmann@seas.upenn.edu

Prof. Graham
Wabiszewski
Senior Design Professor
grahamw@seas.upenn.edu

Full Standing Desk

Of American college students surveyed, 60%
cite cost, space, or transportability as
inhibitive to purchasing a standing desk
solution. This presents a great opportunity for
our market disrupting solution.

Joah Kim & Philip Sieg
Team Advisors
joahkim@seas.upenn.edu
philsieg@seas.upenn.edu
