jonathan-c-lee/elevate/(commit log)

2023-02-12 fixed switch implementation
2023-02-12 added circuit diagrams
2023-02-13 added encoder and multiplexer
2023-02-13 updated files for added encoder and multiplexer
2023-02-13 updated circuits and diagrams
2023-02-14 added more circuits
2023-02-14 made changes for I2C
2023-02-14 added main circuit
2023-02-14 changed input type and added pin numbers
2023-02-14 added circuit links
2023-02-16 updated circuit diagrams
2023-02-24 updated circuits
2023-03-31 new testing prints
2023-04-01 break out of I2C after certain time
2023-04-07 final changes for esp32 test
2023-04-12 working on prototype
2023-04-16 working on new boards
2023-04-19 added calibration functionality, activated modules
2023-04-20 fixed pin numbers
2023-04-20 added hotfix for I2C delay
2023-05-07 added electronics, media, and documents
    [1053131302.stp, 1053141304.stp, 1053141308.stp, 21-0041B_8_MXM.step, 2125280601.stp, 2157601002.stp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]
